lespinozab-lab/ESP-32-RANCAS/equipo_iot_etapa2/pagina.h

// copia comprimida (gzip) de index.html, no editar aca sino correr actualizar_pagina.py
const uint8_t PAGINA_GZ[] PROGMEM = {
  0x1f, 0x8b, 0x08, 0x00, 0x00, 0x00, 0x00, 0x00, 0x02, 0x0a, 0xcd, 0xbd, 0xeb, 0x6e, 0x1b, 0x49, 0xb6, 0x2e, 0xf8, 0x9f,
  0x4f, 0x91, 0xce, 0x42, 0xb7, 0xc8, 0x32, 0x49, 0xf1, 0xae, 0x0b, 0x25, 0x79, 0xab, 0x6c, 0x55, 0x95, 0x7a, 0x6c, 0x97,
  0xdb, 0x72, 0xf5, 0x65, 0xeb, 0x08, 0x46, 0x92, 0x99, 0x14, 0xd3, 0x26, 0x99, 0xec, 0xcc, 0xa4, 0x2c, 0x95, 0xdb, 0xc0,
  0x79, 0x88, 0xf3, 0x6b, 0xff, 0x9a, 0xfa, 0x33, 0xc0, 0xc6, 0xa0, 0x81, 0x39, 0x68, 0x0c, 0x06, 0xd8, 0x33, 0xc0, 0x01,
  0xda, 0x6f, 0xb2, 0x9f, 0x64, 0xd6, 0xb7, 0x56, 0x44, 0x64, 0x64, 0x32, 0x49, 0xc9, 0x5d, 0x75, 0x80, 0x53, 0xdd, 0x16,
  0x33, 0x23, 0xe3, 0xb2, 0x62, 0xc5, 0x8a, 0x75, 0x8b, 0x15, 0x11, 0x47, 0x8f, 0xfc, 0x68, 0x9c, 0xde, 0x2d, 0x03, 0x67,
  0x9a, 0xce, 0x67, 0x27, 0x95, 0x23, 0xfc, 0x38, 0x33, 0x6f, 0x71, 0x7d, 0xec, 0x06, 0x89, 0x8b, 0x84, 0xc0, 0xf3, 0xe9,
  0x67, 0x1e, 0xa4, 0x9e, 0x33, 0x9e, 0x7a, 0x71, 0x12, 0xa4, 0xc7, 0xee, 0x2a, 0x9d, 0x34, 0xf6, 0x5d, 0x9d, 0xbc, 0xf0,
  0xe6, 0xc1, 0xb1, 0x7b, 0x13, 0x06, 0x1f, 0x96, 0x51, 0x9c, 0xba, 0xce, 0x38, 0x5a, 0xa4, 0xc1, 0x82, 0xb2, 0x7d, 0x08,
  0xfd, 0x74, 0x7a, 0xec, 0x07, 0x37, 0xe1, 0x38, 0x68, 0xf0, 0x4b, 0xdd, 0x09, 0x17, 0x61, 0x1a, 0x7a, 0xb3, 0x46, 0x32,
  0xf6, 0x66, 0xc1, 0x71, 0x1b, 0x95, 0xa4, 0x61, 0x3a, 0x0b, 0x4e, 0x5e, 0x44, 0xf4, 0x25, 0x8a, 0x83, 0xc8, 0xf1, 0x83,
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
  0x14, 0x1e, 0xf7, 0x5b, 0xad, 0xa1, 0x3d, 0xc2, 0x18, 0x3a, 0x05, 0xc7, 0xc8, 0x23, 0xae, 0x33, 0x0e, 0x18, 0xfe, 0x64,
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
};
const size_t PAGINA_GZ_LARGO = sizeof(PAGINA_GZ);
