lespinozab-lab/ESP-32-RANCAS/(commit log)

2026-11-03 Codigo inicial del equipo IoT rio San Juan
    Firmware ESP32 (etapa 1 y 2), pagina que sirve el equipo, pantalla OLED,
    prueba de SD, scripts de nube (Supabase), simuladores y esquema de conexiones.
    Las claves (claves.h, claves_nube.h) quedan fuera por .gitignore.
2026-11-03 Turbidez: umbral de medicion valida de 0.3 a 0.7 V
    Con el pin de turbidez suelto (equipo sin sensor) la senal flota entre
    0.21 y 0.33 V; a veces pasaba de 0.3 V, el equipo calculaba 3000 NTU y
    encendia una alerta falsa. Con sensor, aun en agua muy turbia, la senal
    no baja de ~1.2 V, asi que 0.7 V separa bien los dos casos.
    - turbValida() y la calibracion con el boton usan 0.7 V
    - pantalla.h usa phValido()/turbValida() en vez de repetir los numeros
    - mismo umbral en index.html (pagina.h regenerada), extraer_datos.py
    y la simulacion de conexiones
    Probado en el pinguino (898FC8): 40 s sin alertas falsas.
2026-11-03 Quitar del repo imagenes generadas y copia vieja de la pagina
    Las PNG y PDF de simulacion_conexiones/ salen de capturas_simulacion.py
    (una era un duplicado _v2) y "mascota animada.html" es una copia vieja
    de index.html. Siguen en la laptop; .gitignore evita que vuelvan a subir.
2026-11-03 Sacar del repo el SQL con las claves de los equipos
2026-11-05 Pagina: no decir "Agua bien" si falta pH o turbidez
    "Agua bien" ahora pide las dos lecturas validas: si falta una y no hay
    alerta sale "Faltan datos". Una conductividad de 0 cuenta como sin dato,
    porque el equipo manda 0 cuando su sensor no da senal.
2026-11-05 Pagina: avisar cuando un punto deja de enviar
    Aviso arriba con el punto y hace cuanto dejo de enviar. "Sin senal" baja
    de 3 min a 1 min. Solo sale si la base confirma el silencio de un equipo
    que ya habia enviado: un error de red de quien mira no lo dispara.
    [pagina.h]
2026-11-05 Mapa: calles de Esri y reencuadre al mostrarlo
    CARTO ahora pide clave: sin ella responde 200 con una imagen "API KEY
    REQUIRED", asi que "Calles" no mostraba nada. Se usa World_Street_Map de
    Esri, el mismo proveedor del satelite.
    Si la pagina abria en vista sencilla el mapa nacia oculto y quedaba en
    zoom 0 aunque luego se mostrara. Al cambiar de vista se vuelve a encuadrar.
2026-11-06 Separar pruebas de mediciones: salidas y lecturas validas
    Tabla salidas (a mano, hora de Peru) y vista lecturas_validas: solo lo que
    cae dentro de una salida y sin valores imposibles. El registro y las
    descargas leen de la vista. Fuera de una salida la pagina dice "En prueba"
    y la norma "Sin dato". Las lecturas crudas no se tocan.
    Incluye --claves-nuevas en preparar_nube.py, que estaba sin commit.
    Pegar el SQL antes de publicar la pagina.
2026-11-06 Graficas: eje segun los datos, cortes en los huecos y puntos sueltos
    El registro va de la primera a la ultima lectura, la linea se corta donde
    no hubo datos y la lectura que queda sola se dibuja como punto. Sin datos,
    la grafica lo dice en vez de mostrar una escala inventada.
